MeletChirino/Linky4Teens/README.md

# Linky4Teens
This is the official repository of the project Linky4Teens developped by:

- CHIRINO CAICEDO Melet
- LABIT Yann

## Planning
