MeletChirino/Linky4Teens/uml/list.md

# List of components
## Temoin 
La liste suivant a les composants pour chaque temoin
- [ATMega328p](https://www.lextronic.fr/microcontroleur-atmega328p-29869.html)
- [Raspberry Pi 3B+](https://www.lextronic.fr/carte-raspberry-pi-3-b-35081.html)
- [Chargeur TP4056](https://www.amazon.fr/ZHITING-Chargeur-Batterie-Protection-Fonctions/dp/B0859X38WL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)
- [Bouton poussoir](https://www.amazon.fr/BOJACK-Interrupteurs-bouton-poussoir-dassortiment-dinterrupteurs/dp/B07ZN11155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)
- 220 Ohms resistor (3)
- 10k Ohms resistor (1)
- [Buzzer](https://fr.rs-online.com/web/p/buzzers-magnetiques/6221455/)
- 100 Ohms resistor (1)
- [Quartz 16MHz](https://www.lextronic.fr/quartz-16-mhz-4079.html)
- 22pF Ceramic capacitor (2)
- [Led RGB](https://fr.rs-online.com/web/p/led/8614307/)
- [Recepteur IR](https://fr.rs-online.com/web/p/recepteurs-ir/0570578/)
- [Pins](https://www.amazon.fr/Aussel-Breakaway-femelle-Connecteur-blindage/dp/B01M69EA9O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)
- [Step up converter](https://www.amazon.fr/amplifier-dalimentation-d%C3%A9veloppement-d%C3%A9Tendeur-convertisseur/dp/B07JF3SW4H)
- [Batterie 26650](https://www.amazon.fr/THENAGD-5000mah-Batteries-Frontale-Rechargeable/dp/B091CL7T4B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)
- [Capteur tactile capacitive](https://www.amazon.fr/Ils-2-5-5-5V-Capacitive-Self-Lock-Arduino/dp/B0769DKZN5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)
- [Accelerometre MMA8451Q](https://fr.rs-online.com/web/p/capteurs-de-mouvement/9054665/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)
- [Moteur de vibration](https://www.amazon.fr/vibration-Excentrique-%C3%A9lectriques-excentrique-Instrument/dp/B07WP2PGBW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)
- [Adaptateur pour carte MicroSD](https://www.amazon.fr/kwmobile-Module-Carte-Micro-microcontr%C3%B4leurs/dp/B06XHJTGGC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)

- [Connectiques MOLEX :](https://www.amazon.fr/Connecteur-Femelle-Connecteurs-Broches-Terminals/dp/B082ZLYRRN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)
## Barriere IR
- [Circuit integre 555](https://www.amazon.fr/pi%C3%A8ces-pcs-555-Timer-Just-Honest/dp/B014UWTDLU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)
- [LED IR haute puissance (2)](https://fr.rs-online.com/web/p/led-ir/8769423/)
