MeletChirino/Linky4Teens/latex/img/BarriereIrV1.jpg

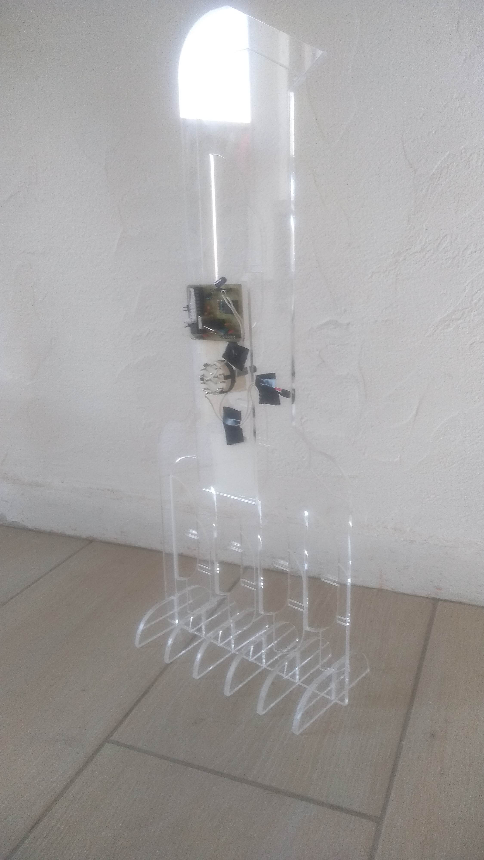
latex/img/BarriereIrV1.jpg
