MeletChirino/Linky4Teens/latex/img/CajaStartingBlock.jpg

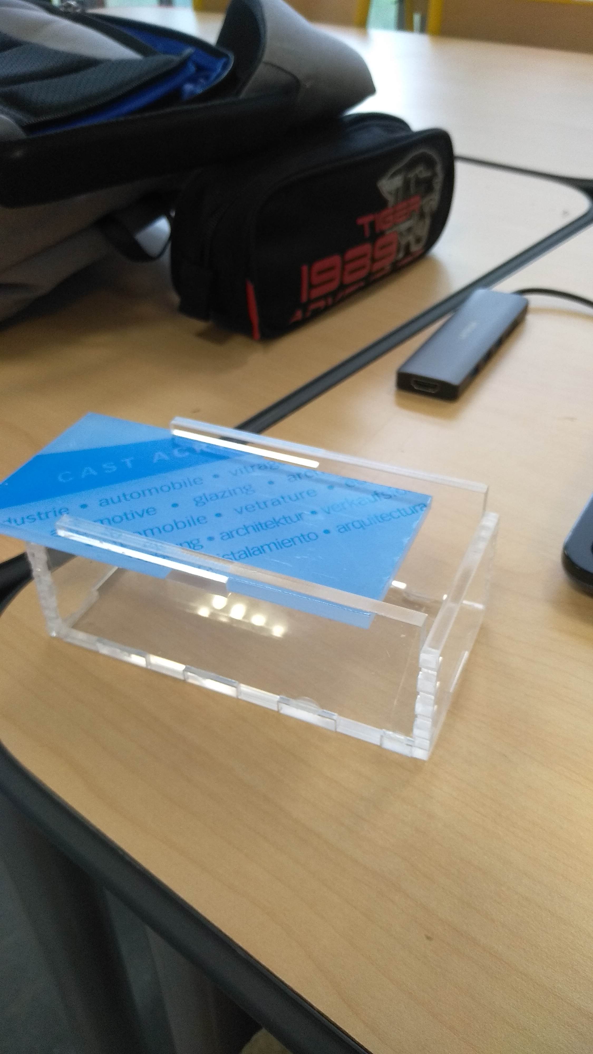
latex/img/CajaStartingBlock.jpg
