MeletChirino/Linky4Teens/soutenance/images/starting_bloc.jpg

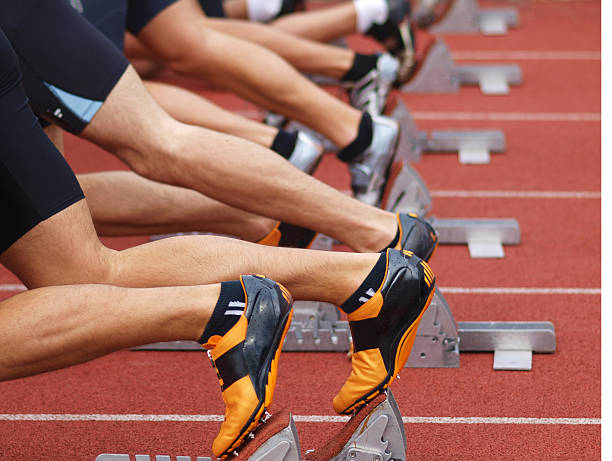
soutenance/images/starting_bloc.jpg
