MeletChirino/Linky4Teens/wifi-direct.png

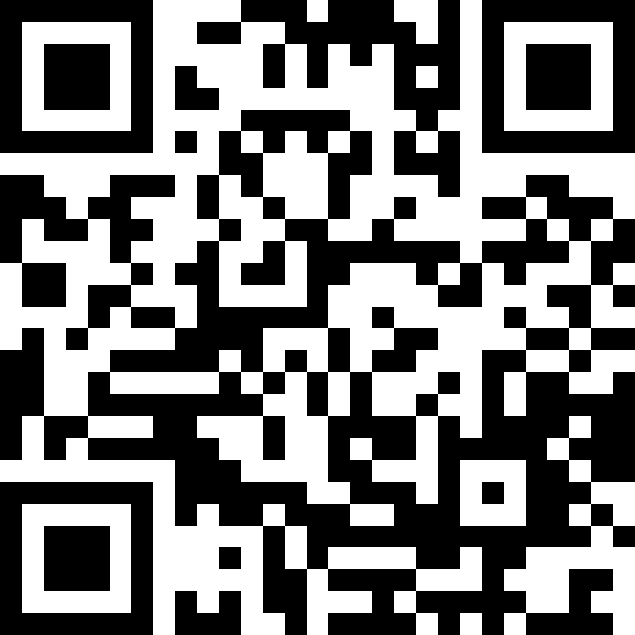
wifi-direct.png
