MeletChirino/Linky4Teens/latex/img/StartingBlockArmado.jpg

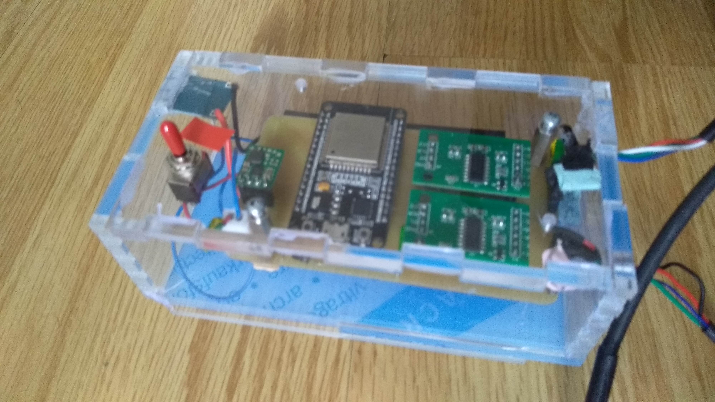
latex/img/StartingBlockArmado.jpg
