MeletChirino/Linky4Teens/latex/img/StartingBlockArmadoAbajo.jpg

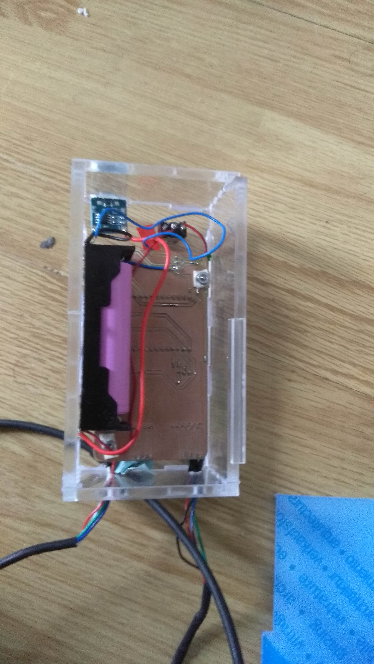
latex/img/StartingBlockArmadoAbajo.jpg
