MeletChirino/Linky4Teens/circuits/Temoin_eagle/temoin.brd

## EAGLE design circuits/Temoin_eagle/temoin.brd (2021-07-28)

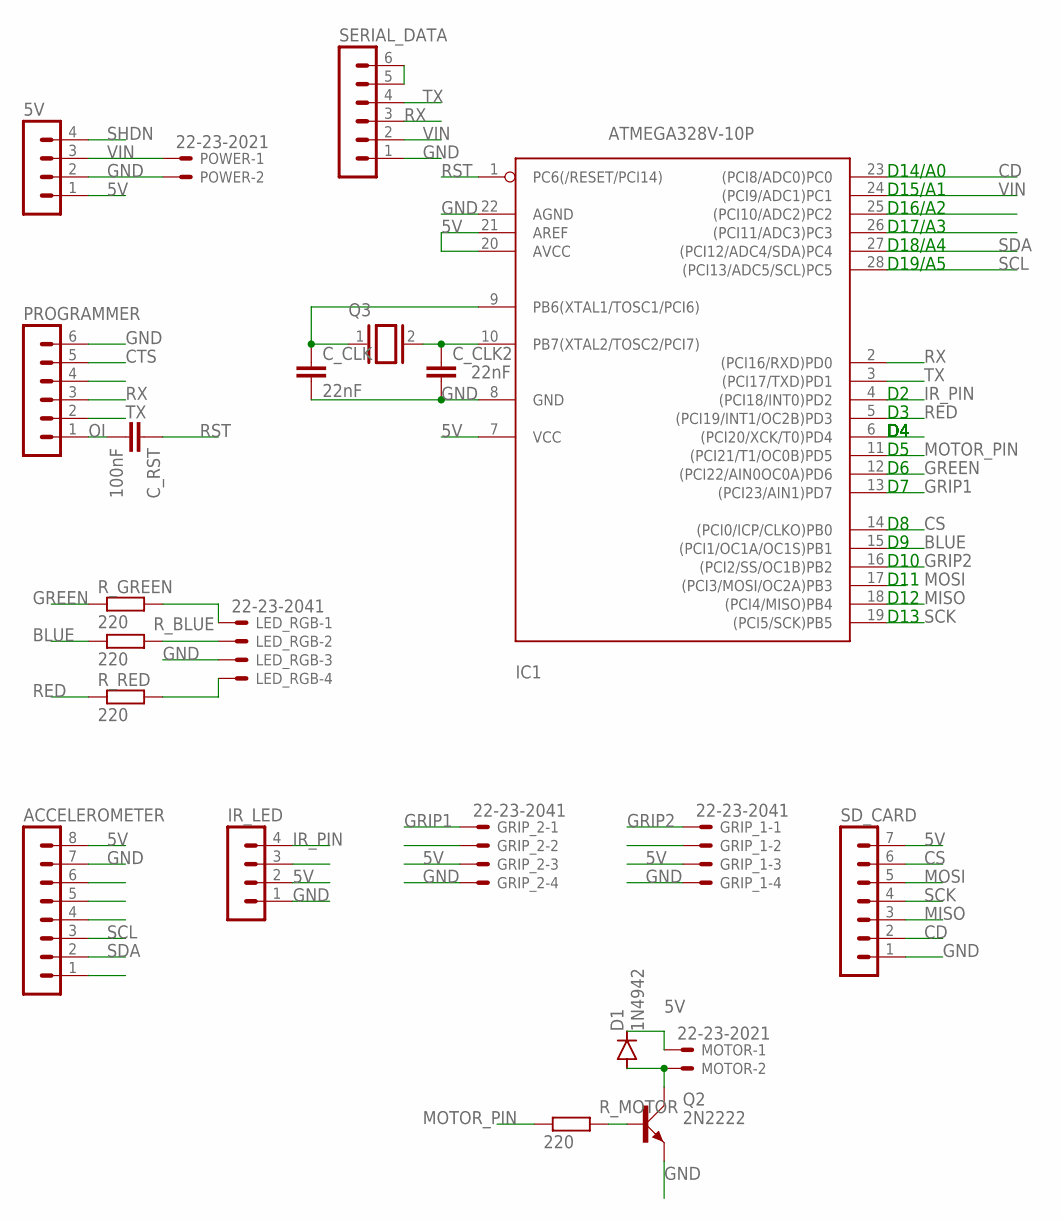
[picture p12: schematic temoin.sch]

Parts:
5V: MA04-1
ACCELEROMETER: MA08-1
C_CLK, C_CLK2: 22nF; C025-025X050
C_RST: 100nF; C025-040X050
D1: 1N4942; DO41-10
GRIP_1, GRIP_2: 22-23-2041
IC1: ATMEGA328V-10P; DIL28-3
IR_LED: MA04-1
LED_RGB: 22-23-2041
MOTOR: 22-23-2021
POWER: 22-23-2021
PROGRAMMER: MA06-1
Q2: 2N2222; TO18A
Q3: XTAL/S; QS
R_BLUE: 220; 0411/12
R_GREEN: 220; 0411/12
R_MOTOR: 220; 0411/12
R_RED: 220; 0411/12
SD_CARD: MA07-1
SERIAL_DATA: MA06-1

Connections:
5V: 5V.1, ACCELEROMETER.8, D1.C, GRIP_1.3, GRIP_2.3, IC1.7 (VCC), IC1.20 (AVCC), IC1.21 (AREF), IR_LED.2, MOTOR.1, SD_CARD.7
BLUE: IC1.15 ((PCI1/OC1A/OC1S)PB1), R_BLUE.1
CD: IC1.23 ((PCI8/ADC0)PC0), SD_CARD.2
CS: IC1.14 ((PCI0/ICP/CLKO)PB0), SD_CARD.6
CTS: PROGRAMMER.5
GND: 5V.2, ACCELEROMETER.7, C_CLK.2, C_CLK2.2, GRIP_1.4, GRIP_2.4, IC1.8 (GND), IC1.22 (AGND), IR_LED.1, LED_RGB.3, POWER.2, PROGRAMMER.6, Q2.E, SD_CARD.1, SERIAL_DATA.1
GREEN: IC1.12 ((PCI22/AIN0OC0A)PD6), R_GREEN.1
GRIP1: GRIP_2.1, IC1.13 ((PCI23/AIN1)PD7)
GRIP2: GRIP_1.1, IC1.16 ((PCI2/SS/OC1B)PB2)
IR_PIN: IC1.4 ((PCI18/INT0)PD2), IR_LED.4
MISO: IC1.18 ((PCI4/MISO)PB4), SD_CARD.3
MOSI: IC1.17 ((PCI3/MOSI/OC2A)PB3), SD_CARD.5
MOTOR_PIN: IC1.11 ((PCI21/T1/OC0B)PD5), R_MOTOR.1
unnamed: LED_RGB.2, R_BLUE.2
unnamed: SERIAL_DATA.5, SERIAL_DATA.6
unnamed: D1.A, MOTOR.2, Q2.C
unnamed: Q2.B, R_MOTOR.2
unnamed: C_CLK2.1, IC1.10 (PB7(XTAL2/TOSC2/PCI7)), Q3.2
unnamed: LED_RGB.1, R_GREEN.2
unnamed: LED_RGB.4, R_RED.2
unnamed: C_CLK.1, IC1.9 (PB6(XTAL1/TOSC1/PCI6)), Q3.1
OI: C_RST.2, PROGRAMMER.1
RED: IC1.5 ((PCI19/INT1/OC2B)PD3), R_RED.1
RST: C_RST.1, IC1.1 (PC6(/RESET/PCI14))
RX: IC1.2 ((PCI16/RXD)PD0), PROGRAMMER.3, SERIAL_DATA.3
SCK: IC1.19 ((PCI5/SCK)PB5), SD_CARD.4
SCL: ACCELEROMETER.3, IC1.28 ((PCI13/ADC5/SCL)PC5)
SDA: ACCELEROMETER.2, IC1.27 ((PCI12/ADC4/SDA)PC4)
SHDN: 5V.4
TX: IC1.3 ((PCI17/TXD)PD1), PROGRAMMER.2, SERIAL_DATA.4
VIN: 5V.3, IC1.24 ((PCI9/ADC1)PC1), POWER.1, SERIAL_DATA.2

Notes on the sheet:
D10
D11
D12
D13
D14/A0
D15/A1
D16/A2
D17/A3
D18/A4
D19/A5

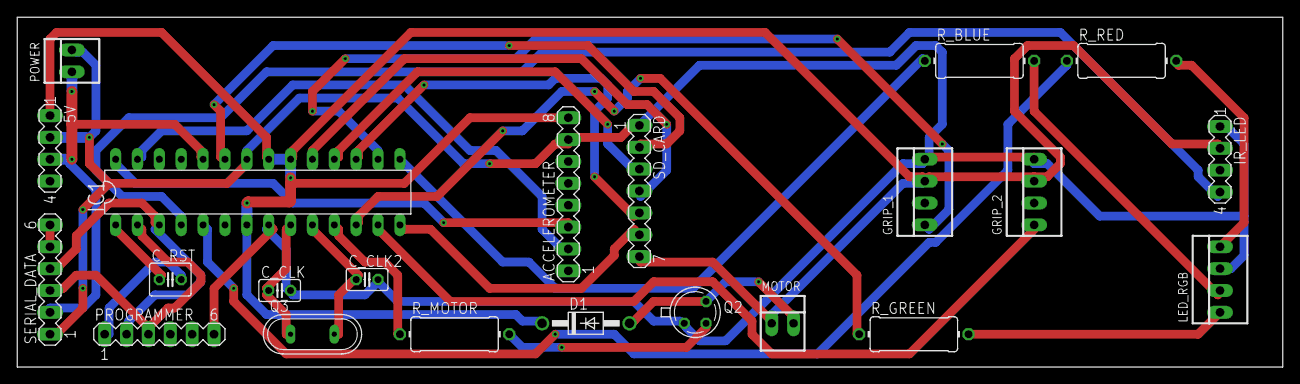
[picture p13: board temoin.brd from above]

Board: 2 copper layers, 147.0 x 40.6 mm, 22 parts (0 on the bottom side), 29 nets.
