MeletChirino/Linky4Teens/circuits/barriere/schema.brd

## EAGLE design circuits/barriere/schema.brd (2021-07-28)

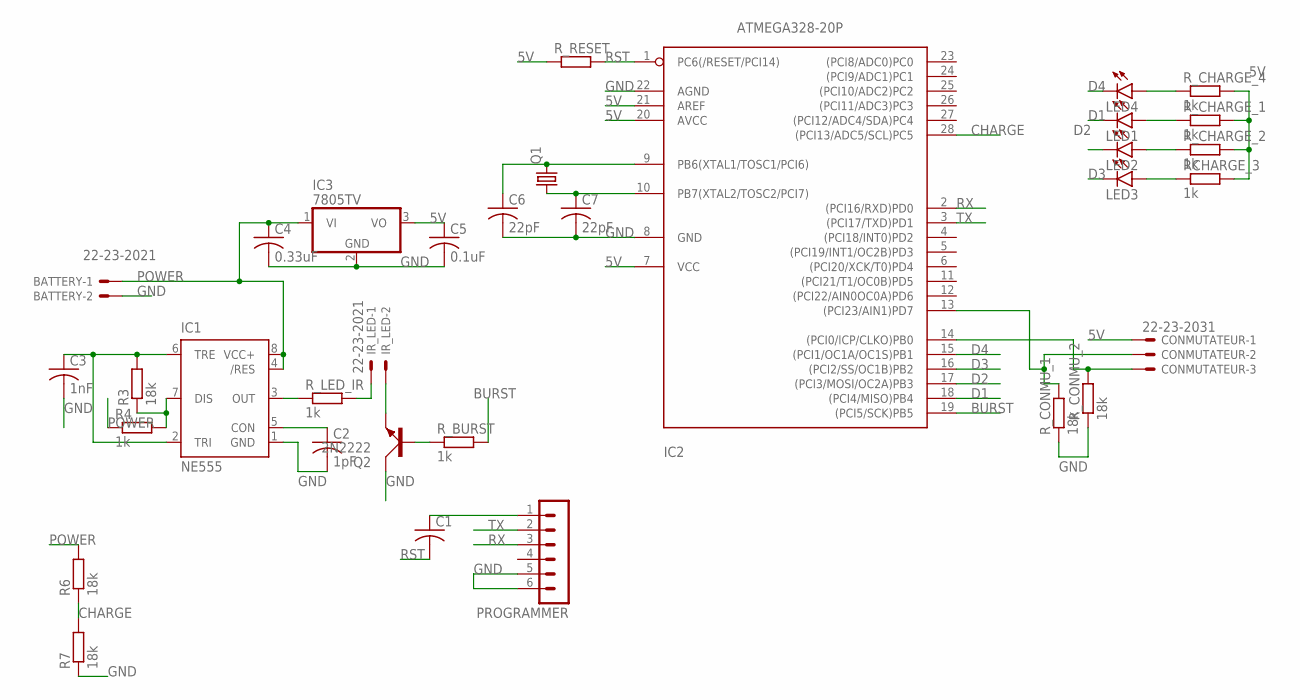
[picture p14: schematic schema.sch]

Parts:
BATTERY: 22-23-2021
C1: C-US050-024X044; C050-024X044
C2: 1pF; C050-024X044
C3: 1nF; C050-024X044
C4: 0.33uF; C050-024X044
C5: 0.1uF; C050-024X044
C6, C7: 22pF; C050-024X044
CONMUTATEUR: 22-23-2031
IC1: NE555; DIL-08
IC2: ATMEGA328-20P; DIL28-3
IC3: 7805TV; TO220V
IR_LED: 22-23-2021
LED1, LED2, LED3, LED4: LED5MM
PROGRAMMER: MA06-1
Q1: CRYSTALHC49S; HC49/S
Q2: 2N2222; TO18A
R3, R6, R7: 18k; 0207/7
R4: 1k; 0207/7
RCHARGE_3: 1k; 0207/7
R_BURST: 1k; 0207/7
R_CHARGE_1, R_CHARGE_2, R_CHARGE_4: 1k; 0207/7
R_CONMU_1, R_CONMU_2: 18k; 0207/7
R_LED_IR: 1k; 0207/7
R_RESET: R-EU_0207/7; 0207/7

Connections:
5V: C5.1, CONMUTATEUR.1, IC2.7 (VCC), IC2.20 (AVCC), IC2.21 (AREF), IC3.3 (VO), RCHARGE_3.2, R_CHARGE_1.2, R_CHARGE_2.2, R_CHARGE_4.2, R_RESET.1
BURST: IC2.19 ((PCI5/SCK)PB5), R_BURST.2
CHARGE: IC2.28 ((PCI13/ADC5/SCL)PC5), R6.1, R7.2
D1: IC2.18 ((PCI4/MISO)PB4), LED1.K (C)
D2: IC2.17 ((PCI3/MOSI/OC2A)PB3), LED2.K (C)
D3: IC2.16 ((PCI2/SS/OC1B)PB2), LED3.K (C)
D4: IC2.15 ((PCI1/OC1A/OC1S)PB1), LED4.K (C)
GND: BATTERY.2, C2.2, C3.2, C4.2, C5.2, C6.2, C7.2, IC1.1 (GND), IC2.8 (GND), IC2.22 (AGND), IC3.2 (GND), PROGRAMMER.5, PROGRAMMER.6, Q2.C, R7.1, R_CONMU_1.1, R_CONMU_2.1
unnamed: IR_LED.1, R_LED_IR.2
unnamed: IC1.3 (OUT), R_LED_IR.1
unnamed: C2.1, IC1.5 (CON)
unnamed: IC1.7 (DIS), R3.1, R4.2
unnamed: C3.1, IC1.2 (TRI), IC1.6 (TRE), R3.2
unnamed: IR_LED.2, Q2.E
unnamed: CONMUTATEUR.2, IC2.13 ((PCI23/AIN1)PD7), R_CONMU_1.2
unnamed: C7.1, IC2.10 (PB7(XTAL2/TOSC2/PCI7)), Q1.1
unnamed: C6.1, IC2.9 (PB6(XTAL1/TOSC1/PCI6)), Q1.2
unnamed: Q2.B, R_BURST.1
unnamed: CONMUTATEUR.3, IC2.14 ((PCI0/ICP/CLKO)PB0), R_CONMU_2.2
unnamed: LED3.A, RCHARGE_3.1
unnamed: LED2.A, R_CHARGE_2.1
unnamed: LED1.A, R_CHARGE_1.1
unnamed: LED4.A, R_CHARGE_4.1
unnamed: C1.1, PROGRAMMER.1
POWER: BATTERY.1, C4.1, IC1.4 (/RES), IC1.8 (VCC+), IC3.1 (VI), R4.1, R6.2
RST: C1.2, IC2.1 (PC6(/RESET/PCI14)), R_RESET.2
RX: IC2.2 ((PCI16/RXD)PD0), PROGRAMMER.3
TX: IC2.3 ((PCI17/TXD)PD1), PROGRAMMER.2

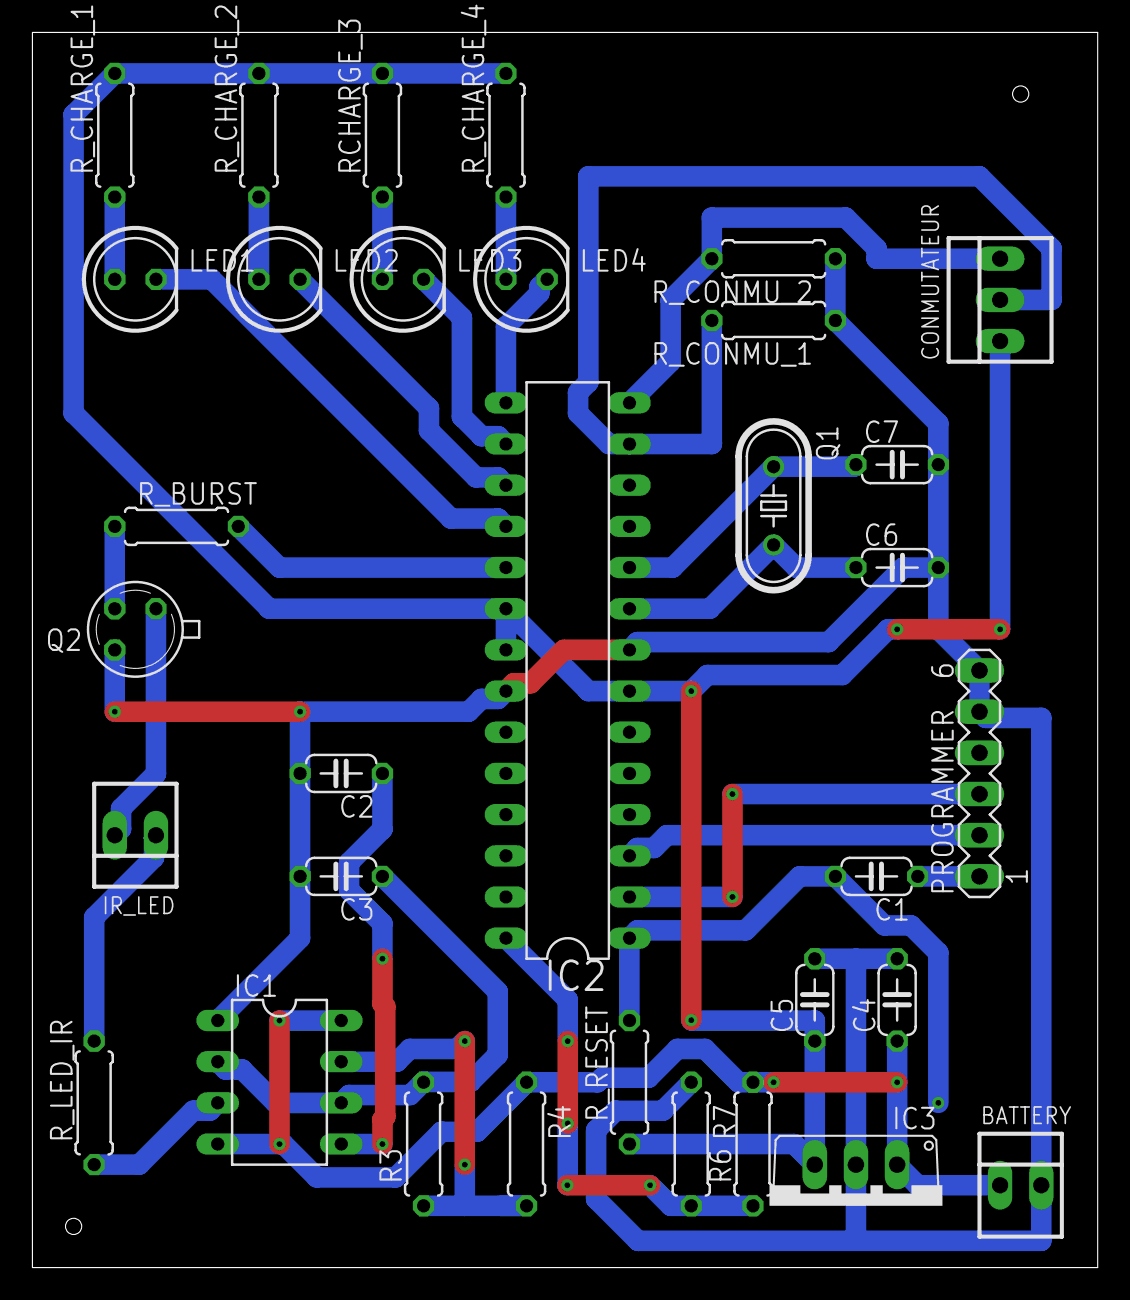
[picture p15: board schema.brd from above]

Board: 2 copper layers, 65.7 x 76.2 mm, 33 parts (0 on the bottom side), 28 nets.
