MeletChirino/Linky4Teens/circuits/start_block/circuit.brd

## EAGLE design circuits/start_block/circuit.brd (2021-07-28)

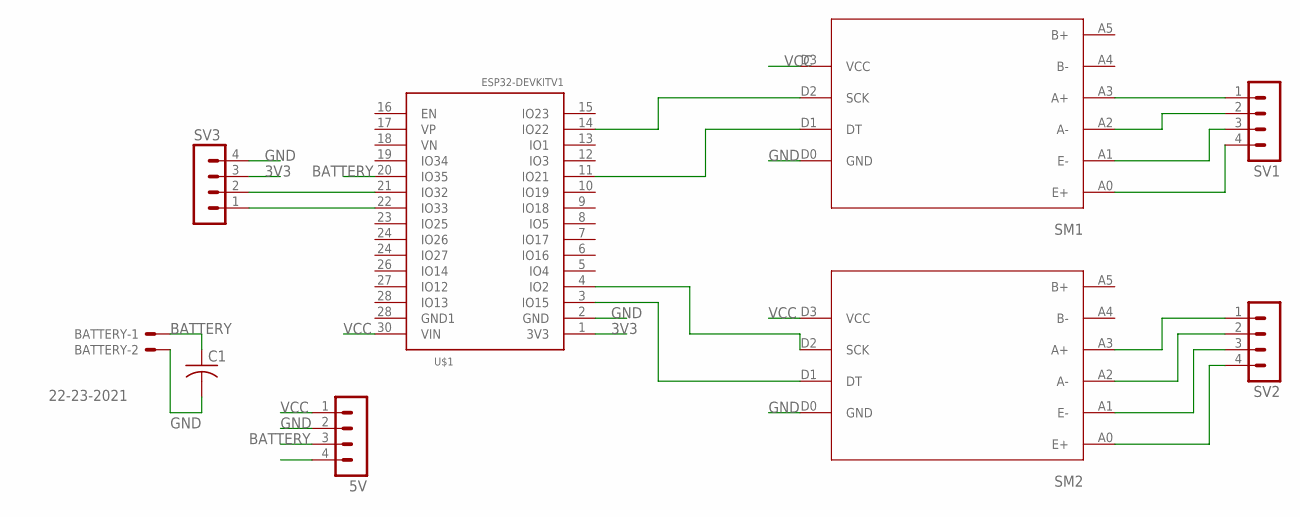
[picture p16: schematic circuit.sch]

Parts:
5V: MA04-1
BATTERY: 22-23-2021
C1: C-US050-055X075; C050-055X075
SM1, SM2: HX711
SV1, SV2, SV3: MA04-1
U$1: ESP32DEVKITV1; ESP32-DEVKITV1

Connections:
3V3: SV3.3, U$1.1 (3V3)
BATTERY: 5V.3, BATTERY.1, C1.1, U$1.20 (IO35)
GND: 5V.2, BATTERY.2, C1.2, SM1.D0 (GND), SM2.D0 (GND), SV3.4, U$1.2 (GND)
unnamed: SM2.A0 (E+), SV2.4
unnamed: SM2.A1 (E-), SV2.3
unnamed: SM2.A2 (A-), SV2.2
unnamed: SM2.A3 (A+), SV2.1
unnamed: SM1.A0 (E+), SV1.4
unnamed: SM1.A1 (E-), SV1.3
unnamed: SM1.A2 (A-), SV1.2
unnamed: SM1.A3 (A+), SV1.1
unnamed: SM1.D2 (SCK), U$1.14 (IO22)
unnamed: SM1.D1 (DT), U$1.11 (IO21)
unnamed: SM2.D1 (DT), U$1.3 (IO15)
unnamed: SM2.D2 (SCK), U$1.4 (IO2)
unnamed: SV3.2, U$1.21 (IO32)
unnamed: SV3.1, U$1.22 (IO33)
VCC: 5V.1, SM1.D3 (VCC), SM2.D3 (VCC), U$1.30 (VIN)

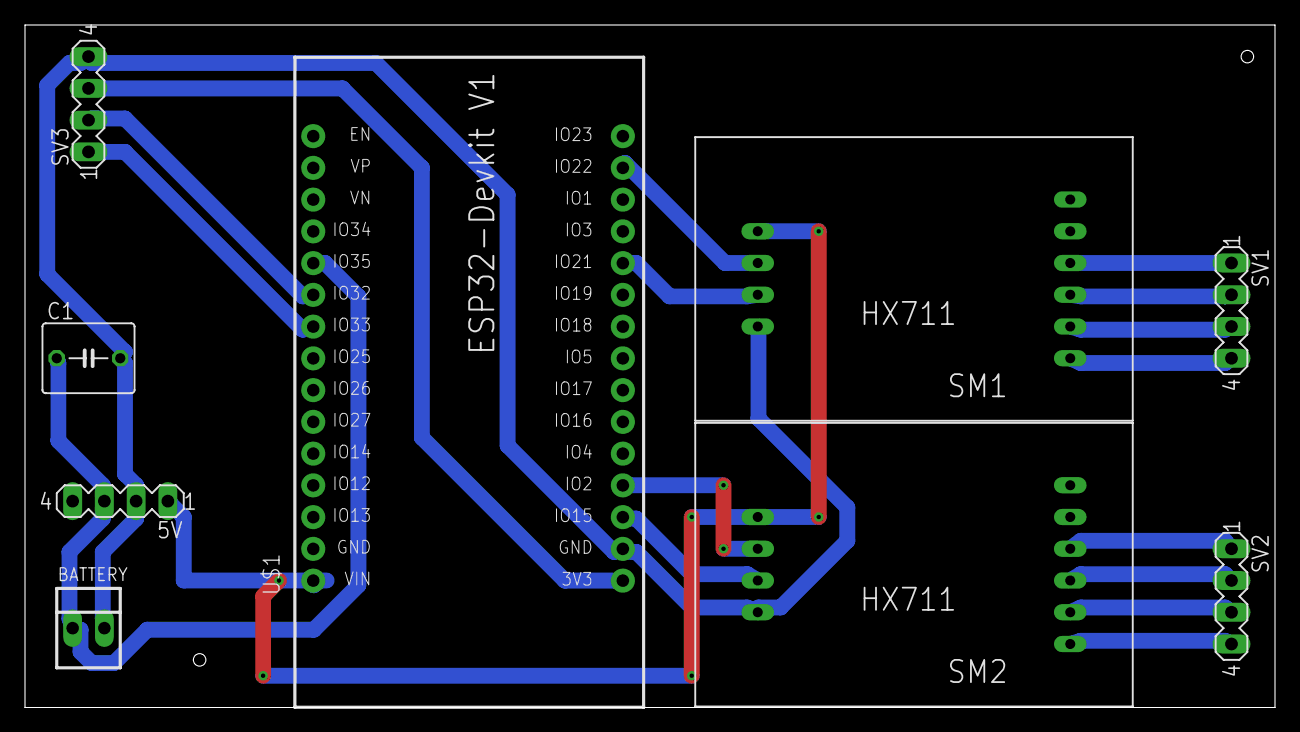
[picture p17: board circuit.brd from above]

Board: 2 copper layers, 100.0 x 54.6 mm, 9 parts (0 on the bottom side), 18 nets.
