MeletChirino/Linky4Teens/start_point/Start_point_server/functions.ino

void send_data(WiFiClient client, float val_1, float val_2, float time_) {
  //Left Force
  client.print(val_1);//left force 1
  //Right Force
  client.print(",");
  client.print(val_2);//right force 1
  //time
  client.print(",");
  client.println(millis() - time_);
  //Left Force
  Serial.print(val_1);//left force 1
  //Right Force
  Serial.print(",");
  Serial.print(val_2);//right force 1
  //time
  Serial.print(",");
  Serial.println(millis() - time_);
}
void send_header(WiFiClient client) {
  //Left Force
  client.print("l_force");//left force 1
  //Right Force
  client.print(",");
  client.print("r_force");//right force 1
  //time
  client.print(",");
  client.println("time");
}
void send_battery_charge(WiFiClient client) {
  //this function reads battery charge in pin 35 and maps it
  //to a percentage value
  // 4.2v - 0.913 = 3.287v -> 100%
  // 3.6v  - 0.913 = 2.687v ->   0%
  int adc_value, charge;
  //float charge;
  adc_value = analogRead(battery_pin);

  charge = adc_value * 0.130 - 450;

  client.println(charge);
  /*
    Serial.print("Raw = ");
    Serial.print(adc_value);
    Serial.print("charge = ");
    Serial.println(charge);
  */
}
void led_control(String control) {
  if (control == "blink") {
    led_status = !led_status;
    digitalWrite(led_pin, led_status);
  } else if (control == "on") {
    led_status = true;
    digitalWrite(led_pin, led_status);
  }
}
