MeletChirino/Linky4Teens/new_gui/new_gui/urls.py

"""new_gui URL Configuration

The `urlpatterns` list routes URLs to views. For more information please see:
    https://docs.djangoproject.com/en/3.1/topics/http/urls/
Examples:
Function views
    1. Add an import:  from my_app import views
    2. Add a URL to urlpatterns:  path('', views.home, name='home')
Class-based views
    1. Add an import:  from other_app.views import Home
    2. Add a URL to urlpatterns:  path('', Home.as_view(), name='home')
Including another URLconf
    1. Import the include() function: from django.urls import include, path
    2. Add a URL to urlpatterns:  path('blog/', include('blog.urls'))
"""
from django.contrib import admin
from django.urls import path, include
from django.conf.urls.static import static
from django.conf import settings
#local views
from .views import (serial_list, home, update_view,
        )

urlpatterns = [
    path('admin/', admin.site.urls),
    path('home/', home, name='home'),
    path('update/', update_view, name='UpdateView'),
    path(
        'admin2',
        include(
            ('apps.admin2.urls','admin2'),
            namespace='admin2')
        ),
    path(
        'relays',
        include(
            ('apps.relays.urls','relays'),
            namespace='relays')
        ),
    path(
        'start_block',
        include(
            ('apps.start_block.urls','start_block'),
            namespace='start_block')
        ),
] + static(settings.STATIC_URL, document_root=settings.STATIC_ROOT)
