MeletChirino/Linky4Teens/new_gui/new_gui/asgi.py

"""
ASGI config for new_gui project.

It exposes the ASGI callable as a module-level variable named ``application``.

For more information on this file, see
https://docs.djangoproject.com/en/3.1/howto/deployment/asgi/
"""

import os

from django.core.asgi import get_asgi_application

os.environ.setdefault('DJANGO_SETTINGS_MODULE', 'new_gui.settings')

application = get_asgi_application()
