MeletChirino/Linky4Teens/new_gui/new_gui/wsgi.py

"""
WSGI config for new_gui project.

It exposes the WSGI callable as a module-level variable named ``application``.

For more information on this file, see
https://docs.djangoproject.com/en/3.1/howto/deployment/wsgi/
"""

import os

from django.core.wsgi import get_wsgi_application

os.environ.setdefault('DJANGO_SETTINGS_MODULE', 'new_gui.settings')

application = get_wsgi_application()
