MeletChirino/Linky4Teens/(commit log)

2021-04-27 Liste de composants ajouté
2021-04-30 Ajouté raspberry pi
2021-05-06 New circuit that transmit data in a modulated way to send messages to relay stick
2021-05-11 New Raspberry programs added, requierements file updated
2021-05-24 Libraries imported from last project. Also algorithm working for grip sensor when race started
2021-05-25 Arduino program updated to receive information thru serial port. Plus, requirements file updated and DATA.TXT file added
2021-05-26 Documentation added to arduino's program
2021-06-04 Esp32 connects to Raspberry and send data with different options
2021-06-09 ESP32 send info to GUI
2021-06-29 esp32 now sends actual info from sensors, it still need some calibration
2021-06-29 Changes to plot, save and show sensor information
2021-07-01 added circuits of temoins
    [temoin.brd, temoin.sch]
2021-07-04 Start point server is calibrated
2021-07-13 Now shows battery charge for starting block
2021-07-13 Now sends battery charge information to the server
2021-07-23 GUI changes and error solutions
    [urls.py]
2021-07-23 ESP32 sends data and reads the battery to the gui
2021-07-27 Relay app updated and functional
2021-07-27 urls file for relays app added
2021-07-27 Starting block is more stable now, it will always send data, also has a led taht indicates whether connected or not
2021-07-27 Little bug in starting block solved
    [Start_point_server.ino]
2021-07-27 Little change to avoid a print in test server
    [views.py]
2021-07-27 Circuit boards added
    [circuit.brd, circuit.sch, schema.brd, schema.sch]
2021-07-27 New middlware added for reading starting block battery everytime the browser refreshes
2021-08-17 Logiciels de CAO
2021-08-17 Service electronique y la mitad de campus fab
2021-08-17 Raspberry como dock, falta el trabajo futuro
2021-08-18 Modificaciones antes de la revision de adriano y colleen
2021-08-23 [UPDATED] revision de ortografia
2021-08-28 [ADD] latex file to show the stage
2021-08-29 Cambios en el archivo de la soutenance
2021-08-29 [UPDATE] Diagrama de componentes
